NanaVan/ArduinoTriggerSystem/Pic/ACIS_ATmega32U4.png

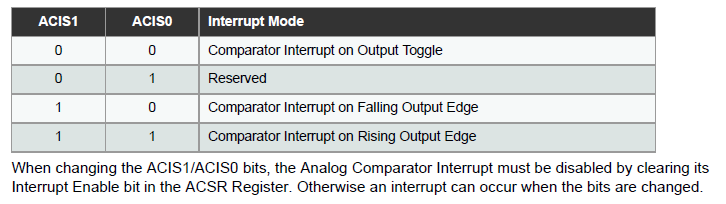
Pic/ACIS_ATmega32U4.png
