NanaVan/ArduinoTriggerSystem/Pic/AINNeg_ATmega32U4.png

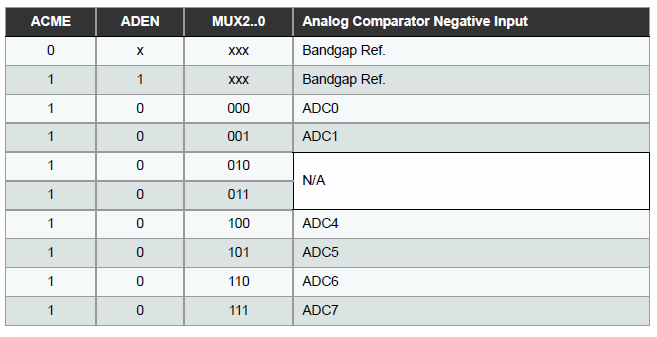
Pic/AINNeg_ATmega32U4.png
