NanaVan/ArduinoTriggerSystem/Pic/PinMapping_ArduinoYun.png

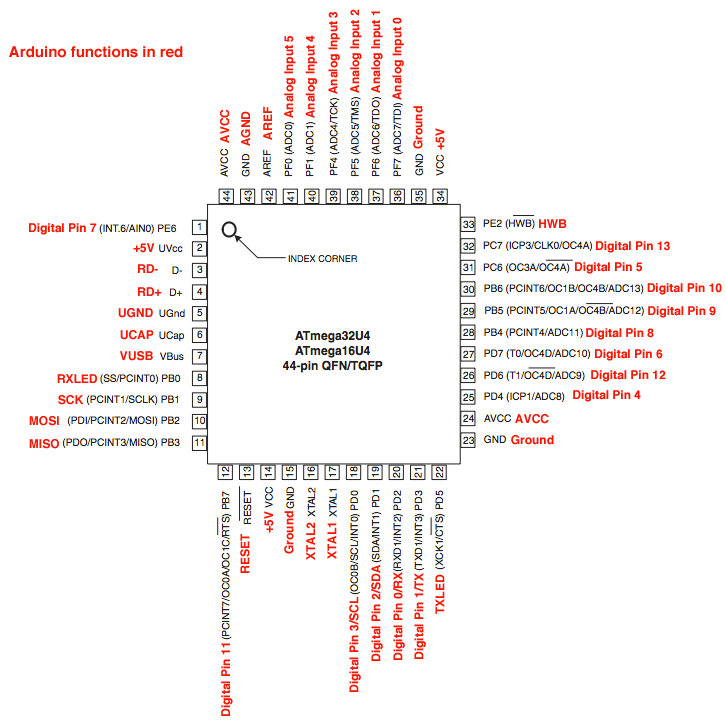
Pic/PinMapping_ArduinoYun.png
