NanaVan/ArduinoTriggerSystem/Pic/DCCharacteristic_ATmega32U4.png

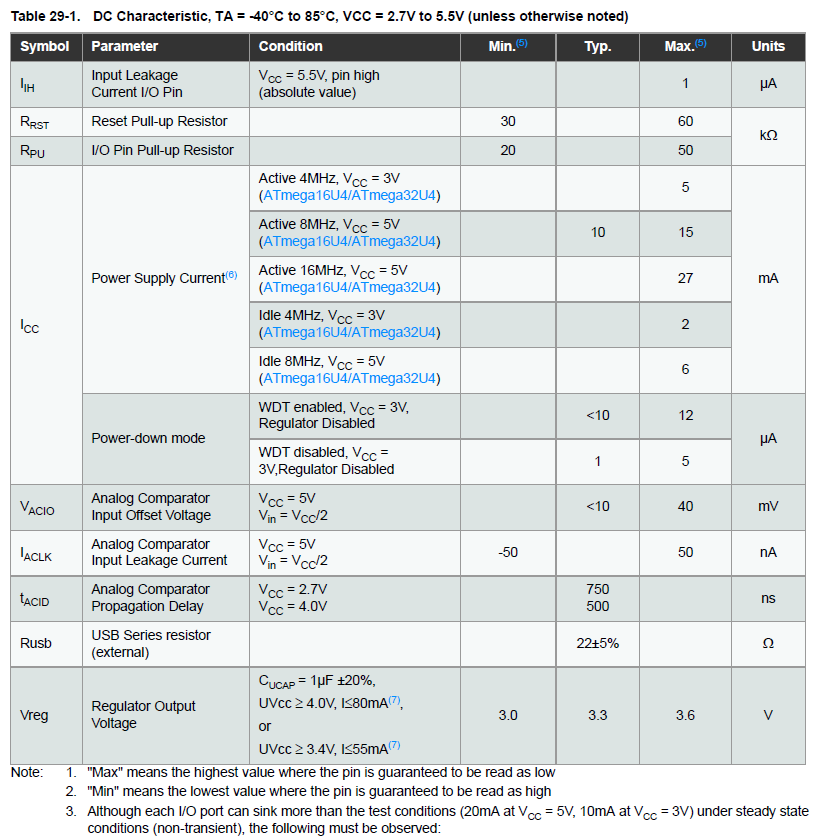
Pic/DCCharacteristic_ATmega32U4.png
