NanaVan/ArduinoTriggerSystem/Pic/UnderTest_ArduinoYun.JPG

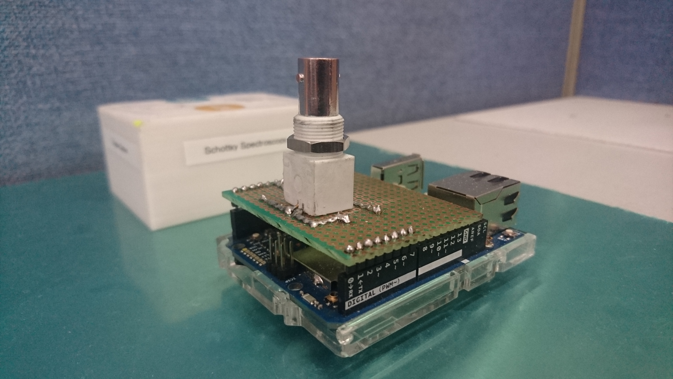
Pic/UnderTest_ArduinoYun.JPG
