NanaVan/ArduinoTriggerSystem/Pic/UnderTest_ArduinoYun.png

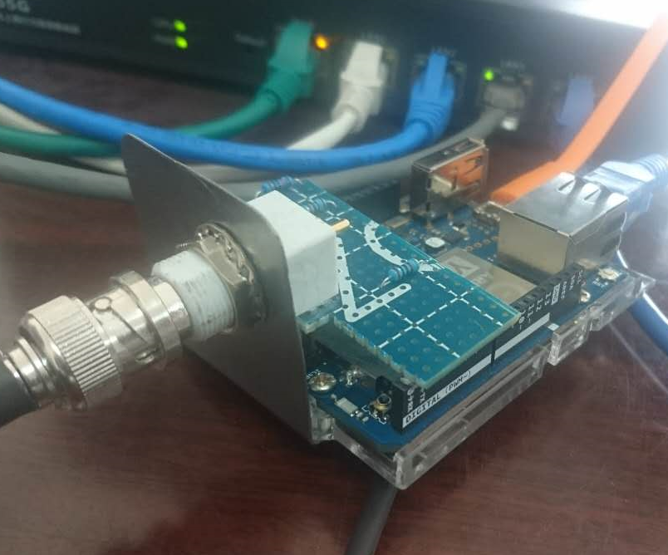
Pic/UnderTest_ArduinoYun.png
